jeffnst/electrical/BBB-Cape/Documentation/Board Snip.PNG

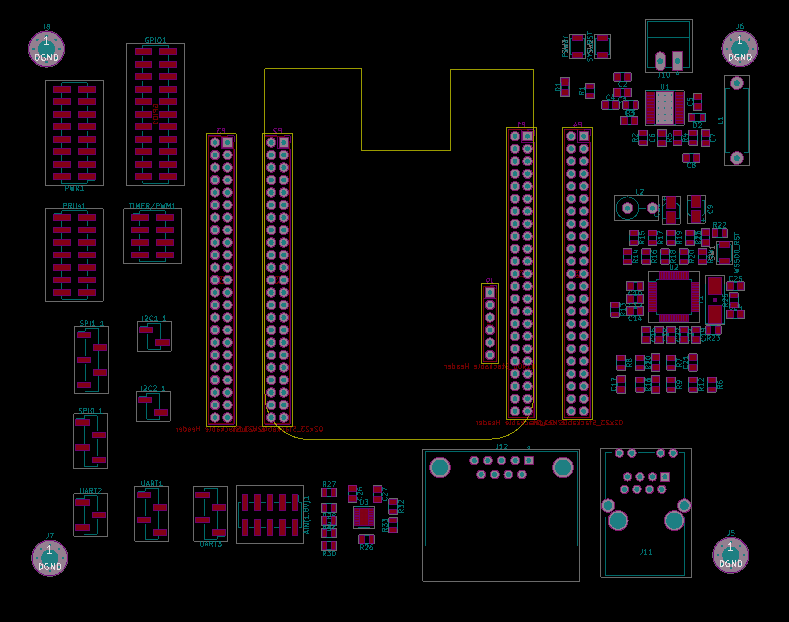
BBB-Cape/Documentation/Board Snip.PNG
