jeffnst/electrical/BBB-Cape/KiCAD v2/BBB-Cape.kicad_pcb

## KiCad design BBB-Cape/KiCAD v2/BBB-Cape.kicad_pcb (2018-02-04)

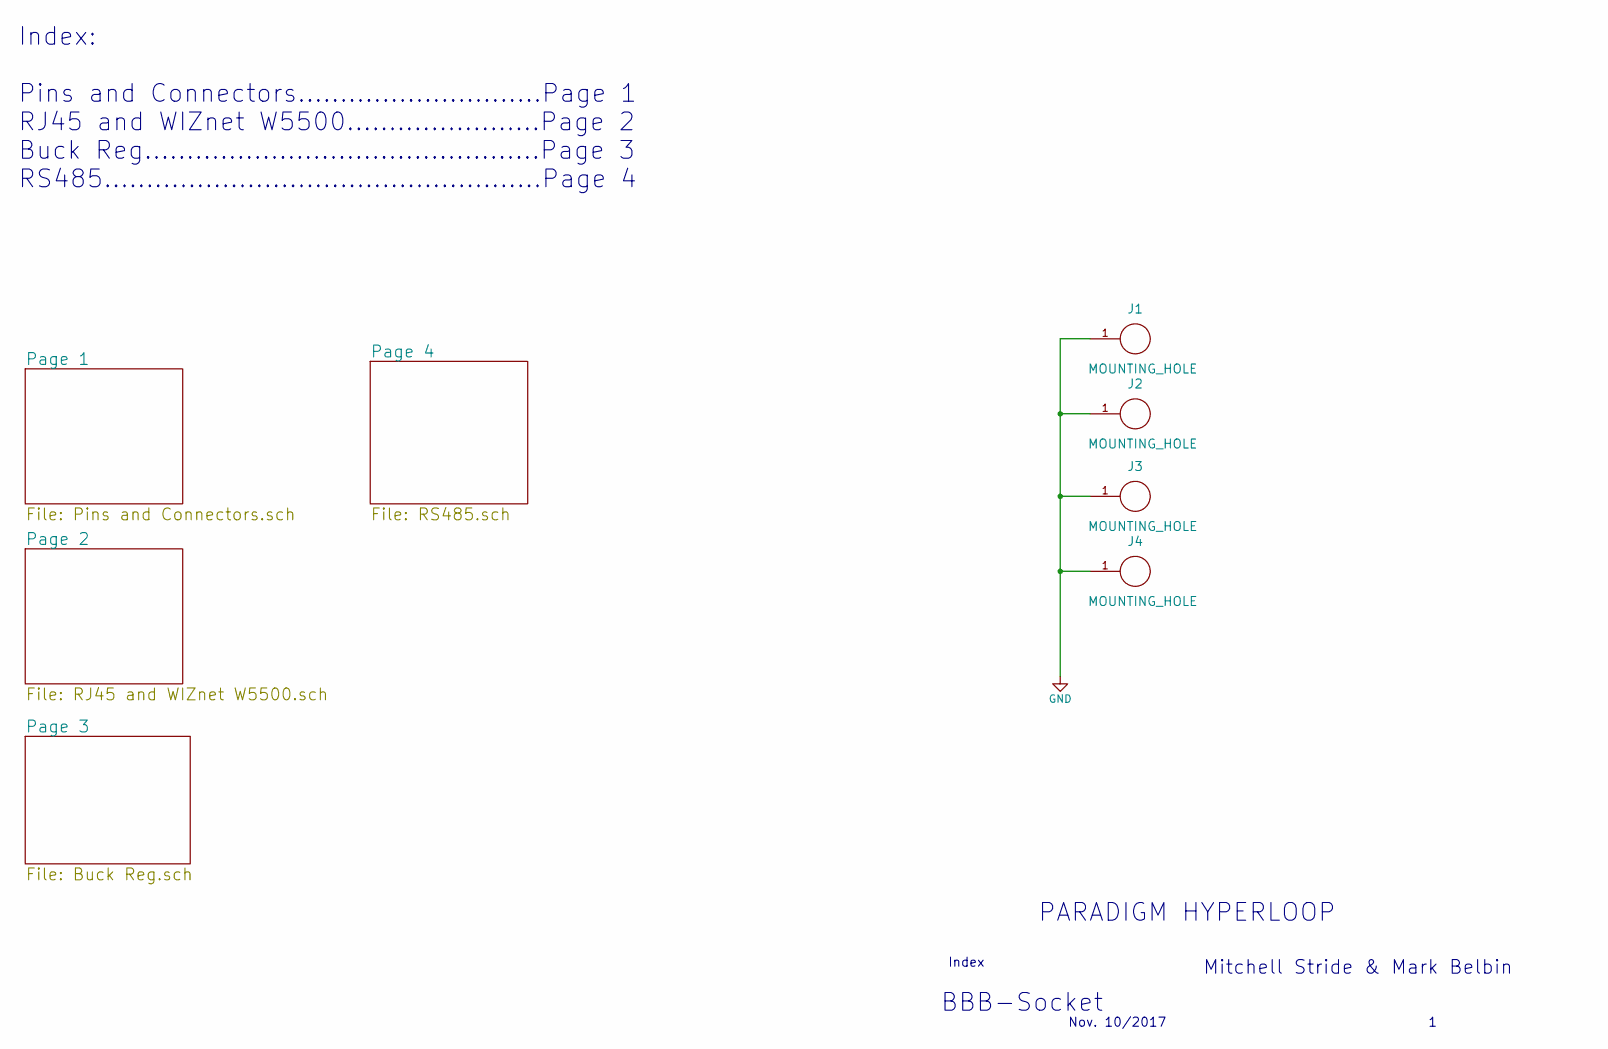
[picture p7: schematic BBB-Cape.sch]

Parts:
J1, J2, J3, J4: MOUNTING_HOLE; MountingHole_3.2mm_M3_Pad

Notes on the sheet:
Index: Pins and Connectors.............................Page 1 RJ45 and WIZnet W5500.......................Page 2 Buck Reg...............................................Page 3 RS485....................................................Page 4
PARADIGM HYPERLOOP
BBB-Socket
Nov. 10/2017
Index
Mitchell Stride & Mark Belbin

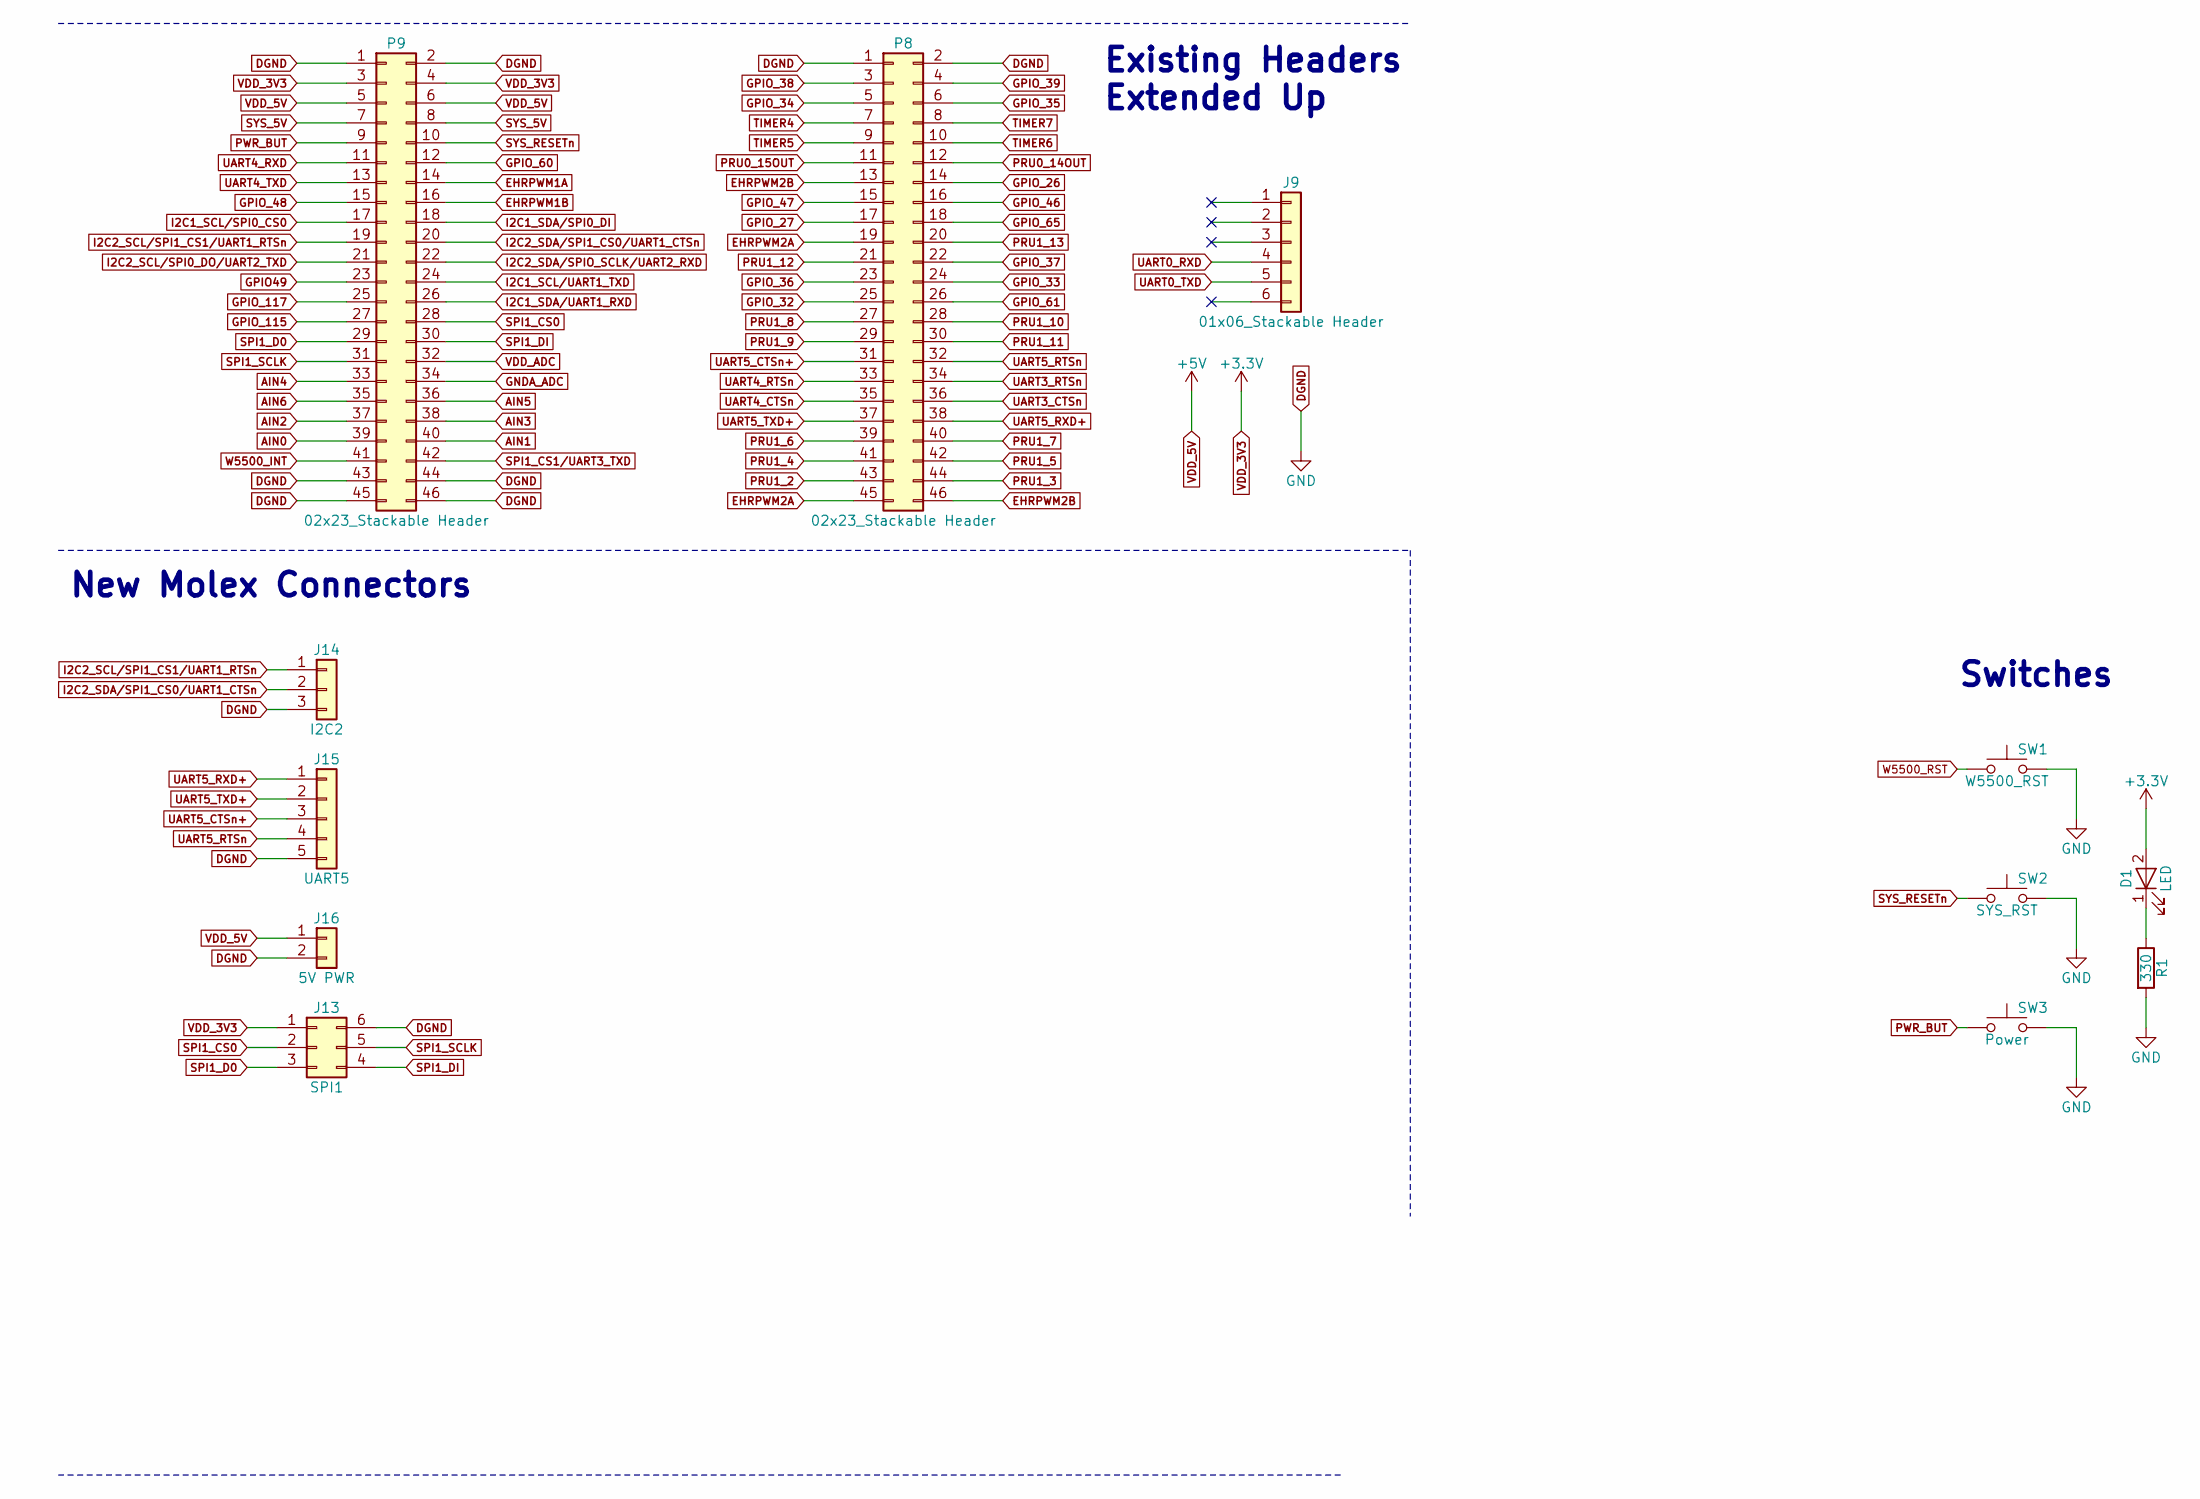
[picture p8: schematic Pins and Connectors.sch]

Parts:
D1: LED; LED_0603
J9: 01x06_Stackable Header; Pin_Header_Straight_1x06_Pitch2.54mm
J13: SPI1; Molex_Microfit3_Header_02x03_Straight_43045-0628
J14: I2C2; Pin_Header_Straight_1x02_Pitch2.54mm_SMD_Pin1Right
J15: UART5; Pin_Header_Straight_1x05_Pitch2.54mm_SMD_Pin1Left
J16: 5V PWR; Molex_KK-6410-02_02x2.54mm_Straight
P8, P9: 02x23_Stackable Header; Pin_Header_Straight_2x23_Pitch2.54mm
R1: 330; R_0603
SW1: W5500_RST; SW_SPST_B3U-1000P
SW2: SYS_RST; SW_SPST_B3U-1000P
SW3: Power; SW_SPST_B3U-1000P

Connections:
AIN0: P9.39
AIN1: P9.40
AIN2: P9.37
AIN3: P9.38
AIN4: P9.33
AIN5: P9.36
AIN6: P9.35
EHRPWM1A: P9.14
EHRPWM1B: P9.16
EHRPWM2A: P8.19, P8.45
EHRPWM2B: P8.13, P8.46
GNDA_ADC: P9.34
GPIO49: P9.23
GPIO_26: P8.14
GPIO_27: P8.17
GPIO_32: P8.25
GPIO_33: P8.24
GPIO_34: P8.5
GPIO_35: P8.6
GPIO_36: P8.23
GPIO_37: P8.22
GPIO_38: P8.3
GPIO_39: P8.4
GPIO_46: P8.16
GPIO_47: P8.15
GPIO_48: P9.15
GPIO_60: P9.12
GPIO_61: P8.26
GPIO_65: P8.18
GPIO_115: P9.27
GPIO_117: P9.25
I2C1_SCL/SPI0_CS0: P9.17; also elsewhere on the board
I2C1_SCL/UART1_TXD: P9.24; also elsewhere on the board
I2C1_SDA/SPI0_DI: P9.18; also elsewhere on the board
I2C1_SDA/UART1_RXD: P9.26; also elsewhere on the board
I2C2_SCL/SPI0_DO/UART2_TXD: P9.21; also elsewhere on the board
I2C2_SCL/SPI1_CS1/UART1_RTSn: J14.1, P9.19
I2C2_SDA/SPI1_CS0/UART1_CTSn: J14.2, P9.20
I2C2_SDA/SPIO_SCLK/UART2_RXD: P9.22; also elsewhere on the board
unnamed: D1.1 (K), R1.1
PRU0_14OUT: P8.12
PRU0_15OUT: P8.11
PRU1_2: P8.43
PRU1_3: P8.44
PRU1_4: P8.41
PRU1_5: P8.42
PRU1_6: P8.39
PRU1_7: P8.40
PRU1_8: P8.27
PRU1_9: P8.29
PRU1_10: P8.28
PRU1_11: P8.30
PRU1_12: P8.21
PRU1_13: P8.20
PWR_BUT: P9.9, SW3.1
SPI1_CS0: J13.2, P9.28
SPI1_CS1/UART3_TXD: P9.42
SPI1_D0: J13.3, P9.29
SPI1_DI: J13.4, P9.30
SPI1_SCLK: J13.5, P9.31
SYS_5V: P9.7, P9.8
SYS_RESETn: P9.10, SW2.1
TIMER4: P8.7
TIMER5: P8.9
TIMER6: P8.10
TIMER7: P8.8
UART0_RXD: J9.4
UART0_TXD: J9.5
UART3_CTSn: P8.36
UART3_RTSn: P8.34
UART4_CTSn: P8.35
UART4_RTSn: P8.33
UART4_RXD: P9.11
UART4_TXD: P9.13
UART5_CTSn+: J15.3, P8.31
UART5_RTSn: J15.4, P8.32
UART5_RXD+: J15.1, P8.38
UART5_TXD+: J15.2, P8.37
VDD_3V3: D1.2 (A), J13.1, P9.3, P9.4; also elsewhere on the board
VDD_5V: J16.1, P9.5, P9.6; also elsewhere on the board
VDD_ADC: P9.32
W5500_INT: P9.41; also elsewhere on the board
W5500_RST: SW1.1; also elsewhere on the board

Notes on the sheet:
Existing Headers Extended Up
New Molex Connectors
Switches

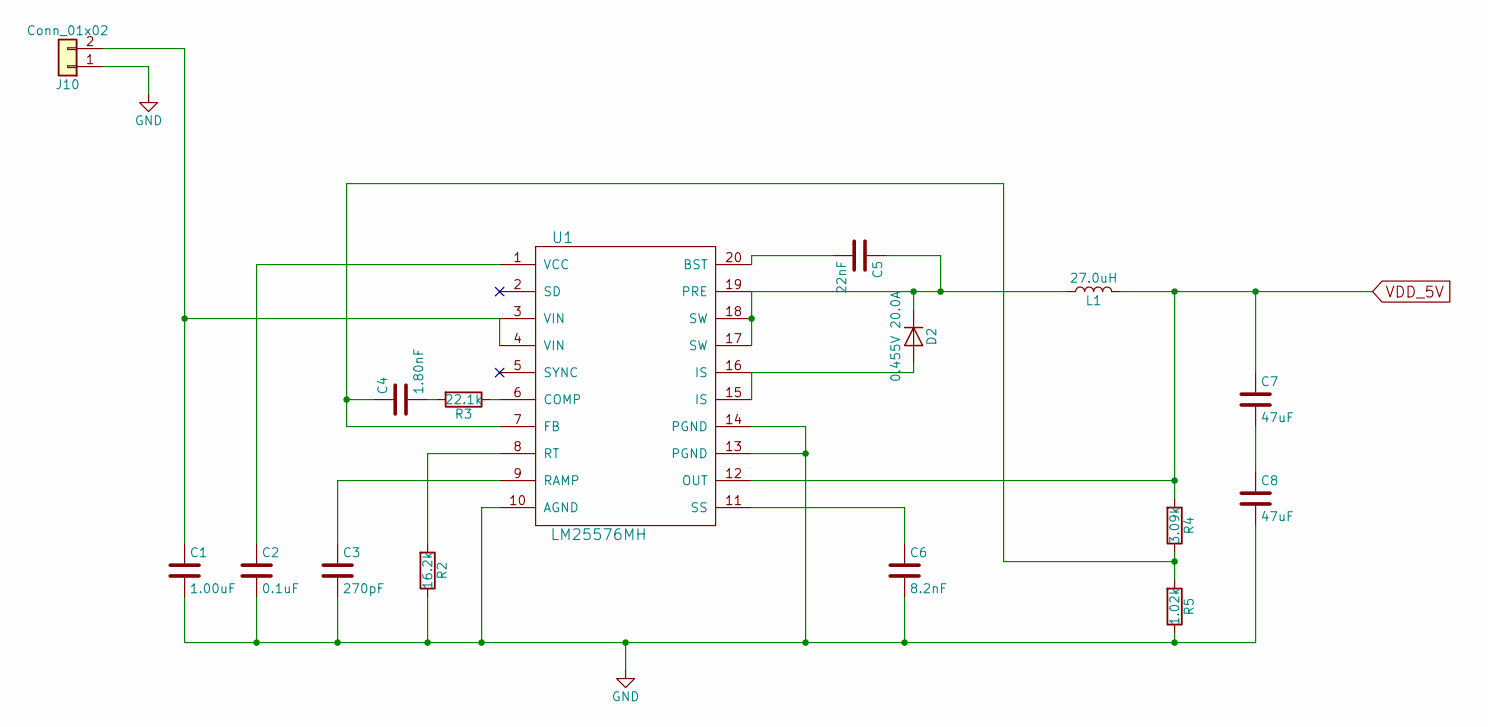
[picture p9: schematic Buck Reg.sch]

Parts:
C1: 1.00uF; C_0603
C2: 0.1uF; C_0603
C3: 270pF; C_0603
C4: 1.80nF; C_0603
C5: 22nF; C_0603
C6: 8.2nF; C_0603
C7, C8: 47uF; C_0603
D2: 0.455V 20.0A; D_0805
J10: Conn_01x02; PhoenixContact_MC-G_02x3.50mm_Angled
L1: 27.0uH; L_Wuerth_HCM-1240
R2: 16.2k; R_0603
R3: 22.1k; R_0603
R4: 3.09k; R_0603
R5: 1.02k; R_0603
U1: LM25576MH; HTSSOP-20-1EP_4.4x6.5mm_Pitch0.65mm_ThermalPad

Connections:
unnamed: C1.1, J10.2, U1.3 (VIN), U1.4 (VIN)
unnamed: C2.1, U1.1 (VCC)
unnamed: C3.1, U1.9 (RAMP)
unnamed: C4.1, R4.1, R5.2, U1.7 (FB)
unnamed: C4.2, R3.2
unnamed: C5.1, D2.1 (K), L1.1, U1.17 (SW), U1.18 (SW), U1.19 (PRE)
unnamed: C5.2, U1.20 (BST)
unnamed: C6.1, U1.11 (SS)
unnamed: C7.2, C8.1
unnamed: D2.2 (A), U1.15 (IS), U1.16 (IS)
unnamed: R2.2, U1.8 (RT)
unnamed: R3.1, U1.6 (COMP)
VDD_5V: C7.1, L1.2, R4.2, U1.12 (OUT); also elsewhere on the board

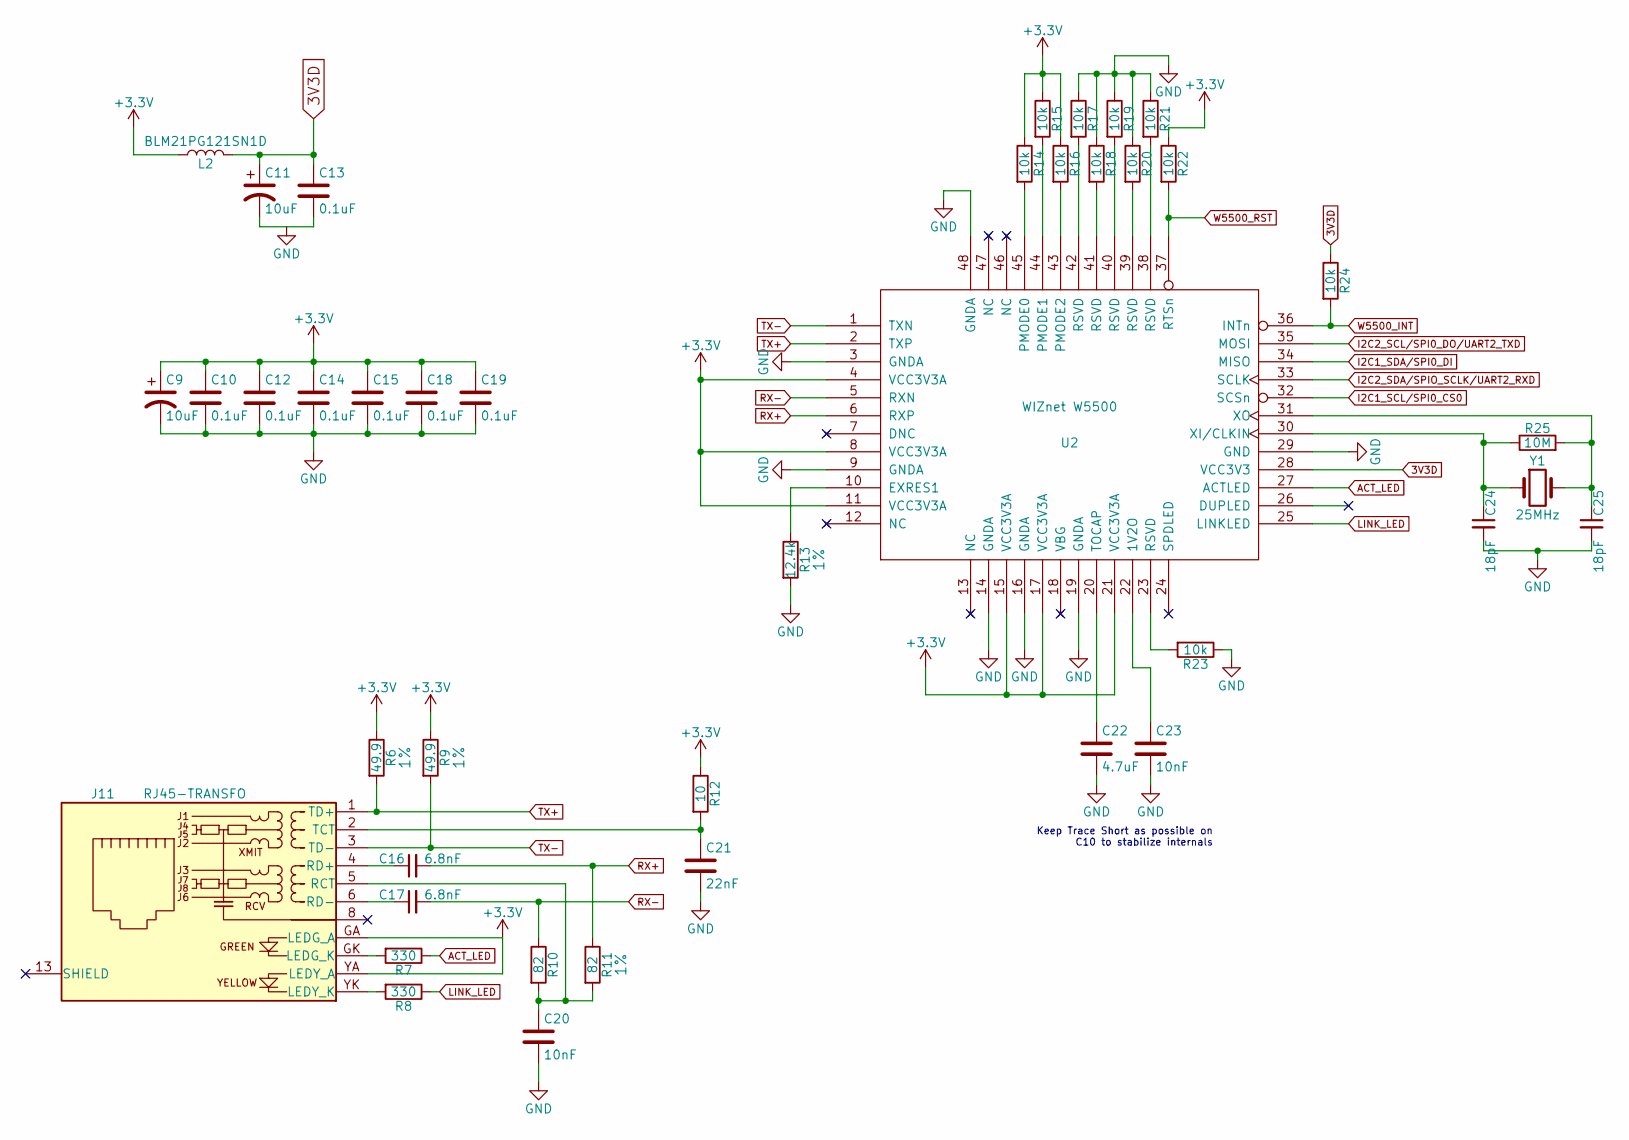
[picture p10: schematic RJ45 and WIZnet W5500.sch]

Parts:
C9, C11: 10uF; CP_Elec_3x5.3; Rating 16V
C10, C12, C13, C14, C15, C18, C19: 0.1uF; C_0603
C16, C17: 6.8nF; C_0603
C20, C23: 10nF; C_0603
C21: 22nF; C_0603
C22: 4.7uF; C_0603
C24, C25: 18pF; C_0603
J11: RJ45-TRANSFO; RJ45_Surface_Mount
L2: BLM21PG121SN1D; L_0805_HandSoldering
R6, R9: 49.9; R_0603; Tolerance 1%
R7, R8: 330; R_0603
R10, R11: 82; R_0603; Tolerance 1%
R12: 10; R_0603
R13: 12.4k; R_0603; Tolerance 1%
R14, R15, R16, R17, R18, R19, R20, R21, R22, R23, R24: 10k; R_0603
R25: 10M; R_0603
U2: WIZnet W5500; LQFP-48_7x7mm_Pitch0.5mm
Y1: 25MHz; Crystal_SMD_0603-2pin_6.0x3.5mm_HandSoldering

Connections:
3V3D: C11.1, C13.1, L2.2, R24.1, U2.28 (VCC3V3)
ACT_LED: R7.1, U2.27 (ACTLED)
I2C1_SCL/SPI0_CS0: U2.32 (SCSn); also elsewhere on the board
I2C1_SDA/SPI0_DI: U2.34 (MISO); also elsewhere on the board
I2C2_SCL/SPI0_DO/UART2_TXD: U2.35 (MOSI); also elsewhere on the board
I2C2_SDA/SPIO_SCLK/UART2_RXD: U2.33 (SCLK); also elsewhere on the board
LINK_LED: R8.1, U2.25 (LINKLED)
unnamed: C16.1, J11.4 (RD+)
unnamed: C17.1, J11.6 (RD-)
unnamed: C20.1, J11.5 (RCT), R10.2, R11.2
unnamed: C21.1, J11.2 (TCT), R12.2
unnamed: C22.1, U2.20 (TOCAP)
unnamed: C23.1, U2.22 (1V2O)
unnamed: C24.1, R25.1, U2.30 (XI/CLKIN), Y1.1
unnamed: C25.1, R25.2, U2.31 (XO), Y1.2
unnamed: J11.GK (LEDG_K), R7.2
unnamed: J11.YK (LEDY_K), R8.2
unnamed: R13.1, U2.10 (EXRES1)
unnamed: R14.2, U2.45 (PMODE0)
unnamed: R15.2, U2.44 (PMODE1)
unnamed: R16.2, U2.43 (PMODE2)
unnamed: R17.2, U2.42 (RSVD)
unnamed: R18.2, U2.41 (RSVD)
unnamed: R19.2, U2.40 (RSVD)
unnamed: R20.2, U2.39 (RSVD)
unnamed: R21.2, U2.38 (RSVD)
unnamed: R23.2, U2.23 (RSVD)
RX+: C16.2, R11.1, U2.6 (RXP)
RX-: C17.2, R10.1, U2.5 (RXN)
TX+: J11.1 (TD+), R6.2, U2.2 (TXP)
TX-: J11.3 (TD-), R9.2, U2.1 (TXN)
VDD_3V3: C9.1, C10.1, C12.1, C14.1, C15.1, C18.1, C19.1, J11.GA (LEDG_A), J11.YA (LEDY_A), L2.1, R6.1, R9.1, R12.1, R14.1, R15.1, R16.1, R22.1, U2.4 (VCC3V3A), U2.8 (VCC3V3A), U2.11 (VCC3V3A), U2.15 (VCC3V3A), U2.17 (VCC3V3A), U2.21 (VCC3V3A); also elsewhere on the board
W5500_INT: R24.2, U2.36 (INTn); also elsewhere on the board
W5500_RST: R22.2, U2.37 (RTSn); also elsewhere on the board

Notes on the sheet:
Keep Trace Short as possible on C10 to stabilize internals

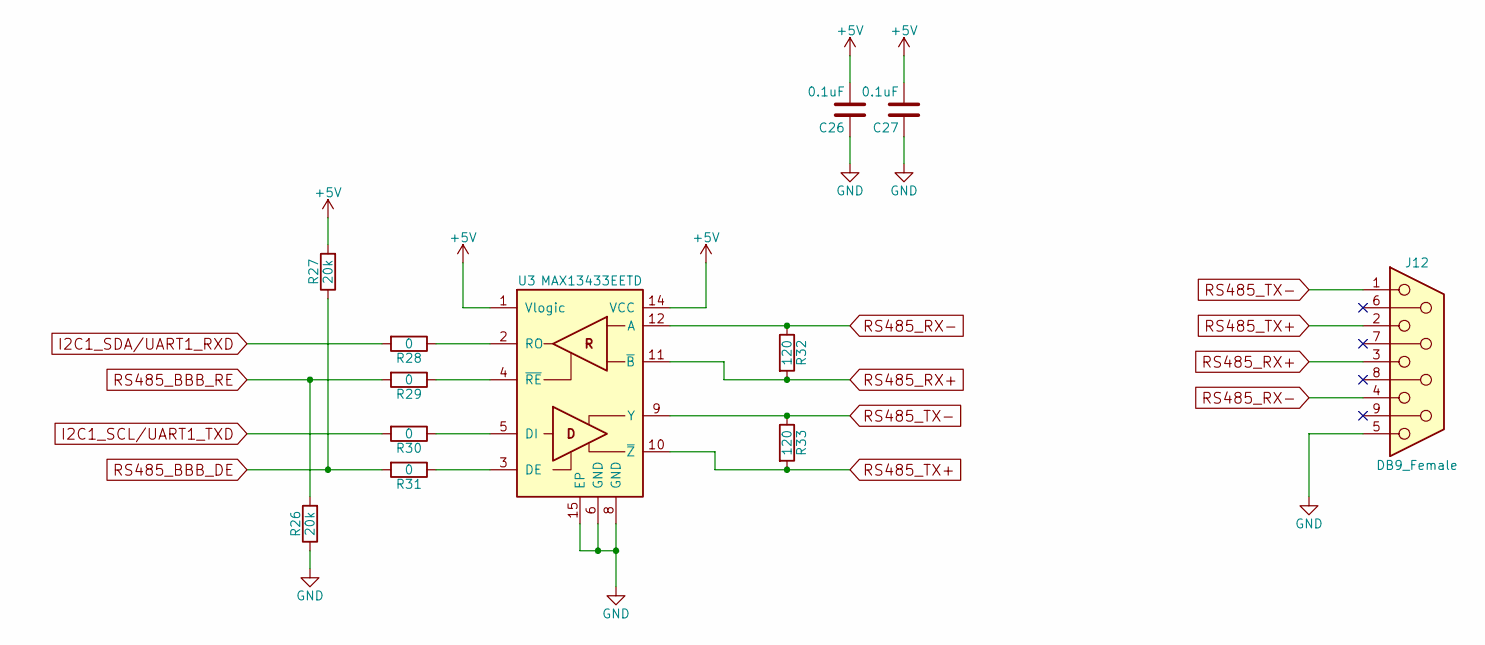
[picture p11: schematic RS485.sch]

Parts:
C26, C27: 0.1uF; C_0603
J12: DB9_Female; DSUB-9_Female_Horizontal_Pitch2.77x2.84mm_EdgePinOffset14.5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
R26, R27: 20k; R_0603
R28, R29, R30, R31: 0; R_0603
R32, R33: 120; R_0603
U3: MAX13433EETD; DFN-14-1EP_3x4mm_Pitch0.5mm

Connections:
I2C1_SCL/UART1_TXD: R30.2; also elsewhere on the board
I2C1_SDA/UART1_RXD: R28.2; also elsewhere on the board
unnamed: R28.1, U3.2 (RO)
unnamed: R29.1, U3.4 (~RE)
unnamed: R30.1, U3.5 (DI)
unnamed: R31.1, U3.3 (DE)
RS485_BBB_DE: R27.1, R31.2
RS485_BBB_RE: R26.2, R29.2
RS485_RX+: J12.3, R32.2, U3.11 (~B)
RS485_RX-: J12.4, R32.1, U3.12 (A)
RS485_TX+: J12.2, R33.2, U3.10 (~Z~)
RS485_TX-: J12.1, R33.1, U3.9 (Y)
VDD_5V: C26.2, C27.2, R27.2, U3.1 (Vlogic), U3.14 (VCC); also elsewhere on the board

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
Board: 2 copper layers, 85 parts (18 on the bottom side), 75 nets, no tracks yet.
