jeffnst/electrical/(commit log)

2018-01-09 BBB for review
    [BBB-Cape.kicad_pcb, BBB-Cape.sch, Buck Reg.sch, Pins and Connectors.sch, RJ45 and WIZnet W5500.sch, RS485.sch]
2018-01-10 Cape Routing Fixes
    General cleanup and optimization.
    [BBB-Cape.kicad_pcb]
2018-01-10 Rev3 started, commit for mark to work on schematic
    [BBB-Cape.csv, BBB-Cape.kicad_pcb, BBB-Cape.sch, Buck Reg.sch, Pins and Connectors.sch, RJ45 and WIZnet W5500.sch, RS485.sch]
2018-01-11 Schematic Rework for Rev3
    Updated schematic based on Ed changes / review.
    [Pins and Connectors.sch]
2018-01-11 Layout start for Rev3
    [BBB-Cape.kicad_pcb]
2018-01-15 Schematic Update
    Updated pin mapping as described by Ed.
    [Pins and Connectors.sch, RJ45 and WIZnet W5500.sch]
2018-01-15 Layout Update
    Changed RJ45 connector to a surface mount component. Need to properly reposition P8 and P9.
    [BBB-Cape.kicad_pcb, Pins and Connectors.sch, RJ45 and WIZnet W5500.sch]
2018-01-15 Layout Fix
    Updated a few footprints, fixed the positioning of P8 and P9, and adjusted general layout a bit.
    [BBB-Cape.kicad_pcb, BBB-Cape.sch]
2018-02-02 Layout Update
    Initial resistor placement. Fixed ethernet connector and RS485 connector position.
    [BBB-Cape.kicad_pcb]
2018-02-04 Connector Position Changes
    Moved around the ethernet and RS485 connectors so they will not interfere with the BBB.
    [BBB-Cape.kicad_pcb]
